Tuur123/GIP/Website/Website_GIP/Website_GIP/luchtvervuiling_3.jpg

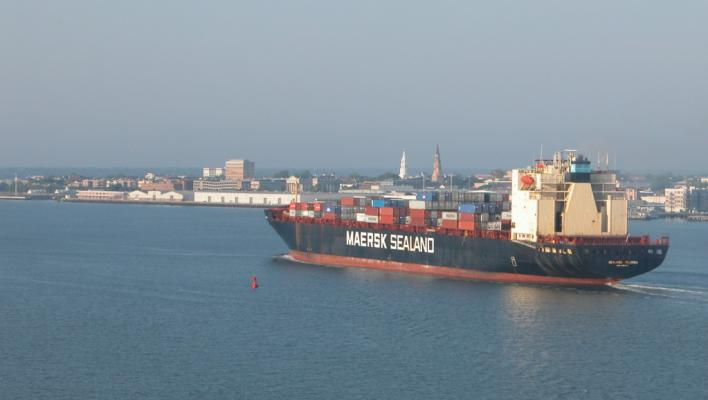
Website/Website_GIP/Website_GIP/luchtvervuiling_3.jpg
