Tuur123/GIP/Website/Website_GIP/Website_GIP/luchtvervuiling_1.jpg

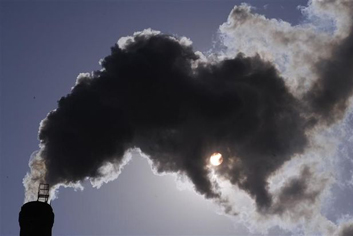
Website/Website_GIP/Website_GIP/luchtvervuiling_1.jpg
