Tuur123/GIP/README.md

# GIP
Luchtkwaliteit

Geïntegreede proef van Arthur d'Hooge en Ruben Socquet
