Tuur123/GIP/GIP-PPT-2_RS_AdH.pptx

## Luchtkwaliteit

Door: R. Socquet & A. d’Hooge

## Samenvatting

- Beoogde eindresultaat
- Belangrijke schema’s
- Werkpunten proces 1
- Stand van zaken

## Beoogde eindresultaat

- Meter dat locatie, tijd, temperatuur, vochtigheid, CO² en lichtsterkte meet.
- Data naar website via WAN module of SD-kaart.
- Metingen gebonden aan de ingelogde gebruiker.
- Grafieken locatie en gebruiker gebonden maken.
- Duidelijk overzicht van de luchtkwaliteit evolutie weergeven.

## Belangrijke schema’s


## Belangrijke schema’s


## Werkpunten proces 1

- Mogelijkheid om data lokaal te bewaren. SD-kaart
- Map op de website. Mapbox
- Intervallen tussen metingen zijn snelheidsafhankelijk.

## Stand van zaken

- Energie voorziening van het meettoestel herbekijken.
- Alle data in clusters op de web pagina.
- Website gebruiksvriendelijker maken.
- Website werkend krijgen (markers)
- Veiligheidsbeleid ontwikkelen
  - User uploaden bestanden
  - Mogelijkheid om data van andere users op te vragen
  - Directe user input naar database (SQL Injection)

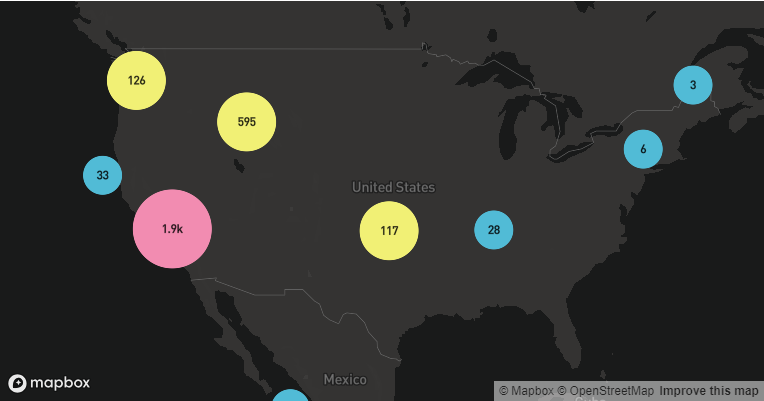
[picture p99: figure]
