Tuur123/GIP/Bundel/To do list 1.0.docx

To do list

- bundel bijwerken – opdrachten proces 3
  - handleiding
- Website datalistener nakijken, volgorde?
- website mooier maken (verdere uitleg toevoegen)(Ruben)
- Website beveiliging?
- website kunnen hosten
