Tuur123/GIP/Bundel/GIP - Opdrachtenbundel - ontwerp.docx

# Opdrachtenbundel

# Geïntegreerde proef 6TICT

# 2018 – 2019

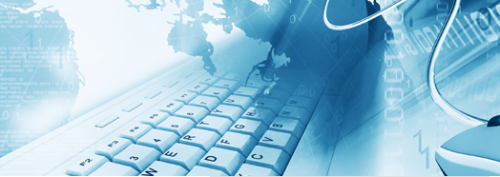
[picture p100: figure]

# Opdrachtenbundel

Opmerking:

De uitwerkingen van de verschillende opdrachten worden steeds toegevoegd aan de GIP-bundel. Bij de opgegeven momenten wordt steeds een volledige bundel afgedrukt en afgegeven aan de GIP-mentor (algemene vakken) en wordt een tweede afdruk gemaakt voor nazicht door de technische leerkrachten.

Bij de evaluatie van de opdrachten kan de attitudeschaal mee in rekening gebracht worden.

# Projectverdeling

Project: | Leerlingen: | Begeleiding:
| | D. Pauwels
| | D. Pauwels
| | D. Pauwels
| | G. Wagemans
| | G. Wagemans
| | G. Wagemans
| | T. Willemsen

# Evaluaties

De evaluatiemomenten met de externe juryleden zullen doorgaan op de volgende momenten:

Procesevaluatie 1 - vrijdag 18 januari

Procesevaluatie 2 - vrijdag 29 maart

Productevaluatie - woensdag 05 juni

In de loop van het ganse schooljaar zal permanente evaluatie, opvolging en begeleiding doorlopend plaatsvinden.

# Projectmatig werken

Opdracht: | Deadlines:
1) Definitiestudie - Werk aan de hand van de projectomschrijving van de GIP een definitiestudie uit die een gedetailleerde beschrijving van het eindresultaat geeft. - Probleemstelling - Specificaties - Functionaliteit - Hardware - Software - Gebruikers - Veiligheid - Etc. | 1e periode = … /01/19 = Procesevaluatie 1
2) Detailontwerp - Werk aan de hand van de definitiestudie het detailontwerp uit. Beschrijf de technische opbouw en werking van de opstelling van het eindproduct. - Schematisch - Hardware - Software en bibliotheken - Dataverwerking - Processturing - Communicatie - Garanties en veiligheid - Etc. | 1e periode = … /01/19 = Procesevaluatie 1
3) Materialenlijst - Stel aan de hand van het detailontwerp een gedetailleerde materialenlijst samen (hardware + software). | 1e periode = … /01/19 = Procesevaluatie 1
4) Dossier Proces 1 - Lever een GIP-dossier in volgens de aangeboden structuur waarin alle onderdelen van de verschillende vakken die deel uitmaken van de GIP uitgewerkt worden volgens de gemaakte afspraken. | 1e periode = … /01/19 = Procesevaluatie 1
5) Presentatie Proces 1 - Maak een presentatie waarin minstens volgende elementen aanwezig zijn: - Titel-dia - Korte omschrijving van je opdracht (zie GIP-info) - Samenvatting van de definitiestudie - Detailontwerp (enkel schema’s, toelichting geef je mondeling) - Stand van zaken (Hoe verloopt het project? Wat staat er nog op de planning? Heb je al testopstellingen gemaakt?) Dien de presentatie minstens één maal in op papier. | 1e periode = … /01/19 = Procesevaluatie 1
6) Voorstelling Proces 1 - Je presentatie zal je mondeling toelichten voor de vakjury. Tijdens deze bespreking wordt er eveneens gekeken naar inzichten en methodische aanpak (SAM-schaal) van het project, alsook kennis over je bundel. Praktische realisaties worden in het labo gedemonstreerd en maken deel uit van de presentatie. | 1e periode = … /01/19 = Procesevaluatie 1

7) Dossier Proces 2 - Lever een GIP-dossier in volgens de aangeboden structuur waarin alle onderdelen van de verschillende vakken die deel uitmaken van de GIP uitgewerkt worden volgens de gemaakte afspraken. | 2e periode = …/03/19 = Procesevaluatie 2
8) Presentatie Proces 2 - Maak een presentatie waarin minstens de volgende elementen aanwezig zijn: - Titel-dia - Omschrijving het beoogde eindresultaat - Toelichting van het detailontwerp - Belangrijke schema’s - Bespreking van de werkpunten die gegeven werden tijdens proces 1 - Huidige stand van zaken + aanpak richting de productevaluatie - … Dien de presentatie minstens één maal in op papier. | 2e periode = …/03/19 = Procesevaluatie 2
9) Voorstelling Proces 2 - Je presentatie zal je mondeling toelichten voor de vakjury. Tijdens deze bespreking wordt er eveneens gekeken naar inzichten en methodische aanpak (SAM-schaal) van het project, alsook kennis over je bundel. Praktische realisaties worden in het labo gedemonstreerd en maken deel uit van de presentatie. | 2e periode = …/03/19 = Procesevaluatie 2

10) Tutorial - Stel een tutorial op voor de ganse opstelling van het GIP-project. Mensen die het systeem zullen onderhouden moeten op documentatie terug kunnen vallen bij de uitvoering van nieuwe installaties, herstellings- en aanpassingswerken. | 3e periode = Bij inleveren dossier = …/05/19 = Productevaluatie
11) Technische conclusie - Formuleer je bevindingen (problemen, oplossingen, moeilijkheden, etc.) in de loop van het project. - Reflecteer over het eindresultaat. | 3e periode = Bij inleveren dossier = …/05/19 = Productevaluatie
12) Zelfreflectie - Evalueer jezelf. Reflecteer over je eigen prestaties, vorderingen, vaardigheden, problemen en competenties die je ondervond tijdens de uitvoering van je opdrachten. | 3e periode = Bij inleveren dossier = …/05/19 = Productevaluatie
13) Peer-evaluatie - Evalueer de samenwerking met anderen. Reflecteer over hun prestaties, vorderingen, vaardigheden, problemen en competenties tijdens samenwerkingen. | 3e periode = Bij inleveren dossier = …/05/19 = Productevaluatie

14) Logboek - Houd nauwkeurig bij welke prestaties je leverde tijdens de uitwerking van het project. Noteer steeds datums, tijdsduur, onderwerp, etc. | 3e periode = Bij inleveren dossier = …/05/19 = Productevaluatie
15) Dossier Product - Lever een GIP-dossier in volgens de aangeboden structuur waarin alle onderdelen van de verschillende vakken die deel uitmaken van de GIP uitgewerkt worden volgens de gemaakte afspraken. - Lever de ontwikkelde broncodes (software) in volgens de gemaakte afspraken. | 3e periode = Bij inleveren dossier = …/05/19 = Productevaluatie
16) Presentatie Product - Maak een presentatie waarin je je GIP-werk voorstelt. Dien de presentatie minstens één maal in op papier. | 3e periode = Bij inleveren dossier = …/05/19 = Productevaluatie
17) Voorstelling Product - Deze presentatie zal je mondeling toelichten voor de vakjury. Tijdens deze bespreking wordt er eveneens gekeken naar inzichten en methodische aanpak (SAM-schaal) van het project, alsook kennis over je bundel. Praktische realisaties worden in het labo gedemonstreerd en maken deel uit van de presentatie. | 3e periode = Bij voorstelling product = …/06/19 = Productevaluatie

# 1) Lokalisatie van wagons

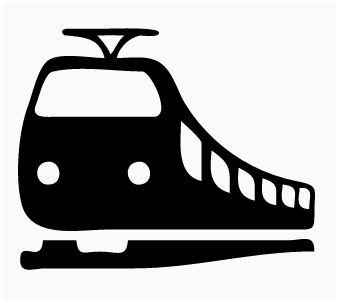
[picture p101: figure]

Leerlingen: Arno & Robbe Breens

## Projectomschrijving

Op een rangeerterrein voor het onderhouden van treinwaggons geraken regelmatig treinstellen tijdelijk verloren. Om het werk van het onderhoudsteam efficiënter te maken zal een systeem uitgebouwd worden dat er voor zorgt dat onderhoudsmedewerkers een specifiek treinstel sneller kunnen localiserern.

Kenmerken:
Gegevens tussen sensoren, actoren, server, camera en bewakingstoepassing worden over een LAN verstuurd.

Kernwoorden:

## Elektronica

Opdracht: | Deadlines:
15) Sensoren en actoren - Werk uit hoe de verschillende sensoren en/of actoren binnen je project aangesloten en gebruikt kunnen worden. Geef dit ook schematisch weer. - Aansluitschema - Elektronisch schema - Ontwikkel de software voor de microcontroller die de aangesloten sensoren en actoren kan uitlezen en aansturen. - Bewegingssensoren - Rooksensor - RFID - Akoestisch alarm - Seriële monitor (voor weergave van testresultaten) - LCD-display (voor weergave van testresultaten) - … | 1e periode = …/01/19 = Procesevaluatie 1

16) Voeding - Bepaal welke spanningen, stromen en vermogens er dienen aanwezig te zijn. Staaf dit met de nodige berekeningen. Ontwerp vervolgens een systeem voor de voorziening van voeding die aan alle eisen voor de opstelling voldoet. Beargumenteer duidelijk je gemaakte keuzes. - Ontwerp de PCB voor de aansluitingen van de voeding(en) die we nodig hebben om alle gevraagde vermogens te kunnen realiseren. | 2e periode = …/03/19 = Procesevaluatie 2
17) PCB design - Ontwerp en ontwikkel de schakeling(en) die gebruikt zal/zullen worden voor het uitmeten van de sensoren en aansturen van signalisatie en/of actuatoren. Gebruik hiervoor professionele ontwikkelsoftware op het gebied van PCB design. | 2e periode = …/03/19 = Procesevaluatie 2
18) PCB ontwikkeling - Ontwerp en ontwikkel een PCB die alle elektronica binnen het project samenbrengt en de nodige aansluitpunten voorziet. Zorg ervoor dat de nodige aansluitingen volgens de regels van goed vakmanschap zijn. Voorzie degelijke kabels (en cable management) om de noodzakelijke verbindingen te realiseren. - Integreer de gepaste voedingsvoorzieningen in de opstelling die de aanwezige schakelingen en componenten van energie voorzien. | 3e periode = Bij inleveren dossier = …/05/19 = Productevaluatie

## ICT

Opdracht: | Deadline:
19) Opbouw LAN-netwerk - Bouw het LAN op dat zal gebruikt worden tijdens het uitwerken van je GIP-project. - Werk een volwaardig netwerkdiagram uit | 1e periode = …/01/19 = Procesevaluatie 1
20) Webdesign - Maak een grafisch ontwerp van je webapplicatie. - Integreer in je project een gebruiksvriendelijke webinterface waarop alle nodige informatie voor je applicatie getoond kan worden, en waarlangs de gebruiker(s) interactie kan/kunnen hebben met de andere onderdelen van de toepassing. - Voorzie binnen je webinterface een plaats waar je eigenschappen van de toepassing kan instellen. | 1e periode = …/01/19 = Procesevaluatie 1
21) Database - De webinterface zal instaan voor het verwerken en bewaren van informatie die stroomt tussen de verschillende nodes van de applicatie. - Integreer in de webinterface van je project de mogelijkheid om gegevens te bewaren in een database. Belangrijke informatie die door de microcontroller of eindgebruikers wordt verzonden zal bewaard moeten worden in de database. - Wanneer een gebruiker van de applicatie gegevens wil bekijken of instellingen wil wijzigen, kan hij deze opvragen uit de database. | 1e periode = …/01/19 = Procesevaluatie 1

22) Netwerkcommunicatie server-microcontroller - Integreer in je project de mogelijkheid om via het LAN communicatie te voeren tussen de webapplicatie en de microcontroller. De webapplicatie kan data ontvangen van de aanwezige microcontroller(s) alsook informatie verzenden naar de microcontroller(s). | 2e periode = …/03/19 = Procesevaluatie 2
23) Netwerk-camera - Integreer de mogelijkheid om via de webinterface videobeelden van een netwerk- of webcamera weer te geven. Sluit een netwerk-camera aan op het LAN. Maak vervolgens een link vanuit de applicatie naar de camera om de videostream te tonen. | 2e periode = …/03/19 = Procesevaluatie 2
24) Toegankelijkheid via LAN - Maak je webapplicatie toegankelijk voor andere toestellen op het LAN. Zorg er voor dat je applicatie bekeken kan worden door meerdere andere (mobiele) toestellen zoals laptops, pc’s, tablets, smartphones, etc. | 3e periode = Bij inleveren dossier = …/05/19 = Productevaluatie
25) Broncode - Optimaliseren van de broncode: Lever alle geschreven software van het project (ook digitaal) in. Optimaliseer de code volgens de aangeleerde technieken. - Commentaar - Stijl - Efficiëntie - Header-informatie - OOP - Foutafhandeling - Etc. | 3e periode = Bij inleveren dossier = …/05/19 = Productevaluatie

## Elektriciteit

Opdracht: | Deadline:
26) Netstelsels - Onderzoek welk netstelsel er gebruikt wordt in je applicatie bij de voorziening van energie. - Maak een gevarenanalyse voor deze situatie. - Verantwoord de gebruikte beveiliging. | 1e periode = …/03/19 = Procesevaluatie 2
27) Vitale 8 - Om veilig te kunnen werken met de installatie is het van cruciaal belang dat je de vitale 8 uit de elektriciteit kent. Bespreek deze regels. | 2e periode = …/03/19 = Procesevaluatie 2
28) Risicoanalyse - Maak een risicoanalyse van de opstelling van je applicatie. | 2e periode = …/03/19 = Procesevaluatie 2
29) Elektrische componenten Onderzoek de types en kenmerken van de gebruikte elektrische toestellen in de praktische opstelling van je applicatie. | 3e periode = Bij inleveren dossier = …/05/19 = Productevaluatie
30) Elektrische schema’s Teken de elektrische schema’s van de omgeving waarbinnen je applicatie zich bevindt met het tekenpakket van SEE-electrical. | 3e periode = Bij inleveren dossier = …/05/19 = Productevaluatie

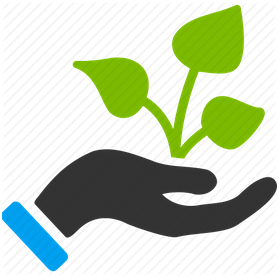
[picture p102: figure]

# 2) Greenhouse

Leerlingen: Robbe Elsermans & Melvin Goorden

## Projectomschrijving

Omwille van economische, ecologische, logistieke en kwalitatieve redenen wordt er in de ontwikkeling van landbouwtechnologieën vollop geëxperimenteerd met het kweken van gewassen in afgesloten omgevingen (indoor). Hiervoor zal een project uitgewerkt worden dat het mogelijk maakt om de eigenschappen van bodem en lucht waarin de gewassen groeien in kaart te brengen en op automatische wijze te beïnvloeden. Dit zal uiteindelijk leiden tot een optimalisatie van de kweekomstandigheden van de gewassen.

Kenmerken:
Er worden metingen uitgevoerd om de eigenschappen van de lucht uit de omgeving op te volgen: - Licht - Temperatuur - Vochtigheid - CO2
Er worden metingen uitgevoerd om de eigenschappen van de bodem uit de omgeving op te volgen: - vochtigheid
Er wordt een irrigatiesysteem uitgewerkt dat instaat voor de bevochtiging van de bodem. Onderzoek hierbij of er gebruik gemakt kan worden van regenwater, leidingwater of een combinatie van beiden.
Een meet- en regelsysteem zorgt voor een egale bevochtiging van de bodem.
Een meet- en regelsysteem zorgt voor een beïnvloeding van de eigenschappen van de lucht.
Er worden metingen uitgevoerd op het verbruik van water en elektriciteit.
De verschillende metingen moeten in kaart gebracht kunnen worden (grafieken/diagram) via een grafische webinterface.
De verschillende instellingen van het systeem moeten via een grafische webinterface instelbaar gemaakt worden.
Een camera maakt beelden van de omgeving waarin de gewassen groeien.
Gegevens tussen sensoren, actoren, webapplicatie en camera worden over een LAN verstuurd.

Kernwoorden:

# 3) Bulletin board

Leerlingen: Liam Smet

## Projectomschrijving

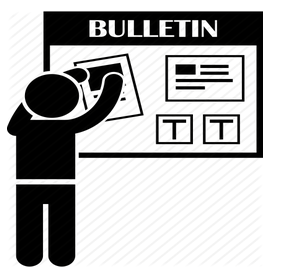
[picture p103: figure]

Om de interne communicatie van een bedrijf te verbeteren wordt een systeem uitgewerkt dat het mogelijk maakt om via een groot scherm mededelingen en algemene informatie te tonen aan personeelsleden. Dergelijk scherm zal op een centrale plaats binnen het bedrijf worden opgehangen.

Voor de beheerder van het systeem moet een interface voorzien worden die het mogelijk maakt om op eenvoudige wijze de boodschappen en inhoud van wat er op het bord verschijnt te kunnen aanpassen.

Kenmerken:
Er worden metingen uitgevoerd om de eigenschappen van de lucht uit de omgeving op te volgen: - Licht - Temperatuur - Vochtigheid
Er wordt een alarmsignaal voorzien dat de aandacht van medewerkers trekt wanneer een zeer belangrijke mededeling op scherm verschijnt.
Een webinterface wordt voorzien om meldingen te tonen en de informatie die via het systeem wordt getoond te beheren.
Een login-systeem voor de administrator van het systeem moet voorzien worden.
De videobeelden van een netwerkcamera tonen in de webinterface de weersomstandigheden buiten het bedrijf.
De verschillende metingen moeten in kaart gebracht kunnen worden (grafieken/diagram) via een grafische webinterface.
Gegevens tussen sensoren, actoren, webapplicatie en camera worden over een LAN verstuurd.

Kernwoorden:

# 4) Luchtkwaliteit

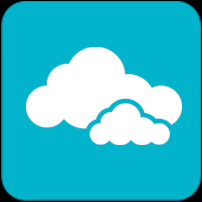
[picture p104: figure]

Leerlingen: Arthur d’ Hooge & Ruben Soquet

## Projectomschrijving

Om de luchtkwaliteit van een bepaalde regio in kaart te brengen zal een systeem uitgewerkt worden dat voor een bepaalde locatie exact kan bepalen welke de eigenschappen van de luchtkwaliteit zijn.

De meetresultaten worden vervolgens samengevoegd en uitgebreid in kaart gebracht.

Kenmerken:
Er worden metingen uitgevoerd om de eigenschappen van de lucht uit de omgeving op te volgen: - Licht - Temperatuur - Vochtigheid - CO2
Voor de verschillende metingen die worden uitgevoerd dient steeds een exacte locatie bepaald te worden aan de hand van GPS-coördinaten.
Het traject dat tijdens het afnemen van de meetproef werd afgelegd wordt in kaart gebracht.
De verschillende metingen moeten in kaart gebracht kunnen worden (grafieken/diagram/landkaart) via een grafische webinterface.
De verschillende instellingen van het systeem moeten via de grafische webinterface instelbaar gemaakt worden.
Een camera maakt beelden van de omgeving tijdens het uitvoeren van de metingen.
Gegevens tussen sensoren, actoren, webapplicatie en camera worden over een netwerk verstuurd.

Kernwoorden:

# 5) Human machine interface voor PLC

Leerlingen: William Bruijns

## Projectomschrijving

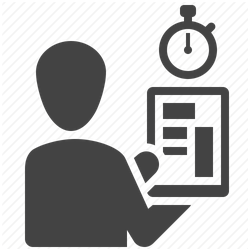
[picture p105: figure]

Voor de bediening van een industriële installatie met PLC’s moet een grafische interface (HMI - human machine interface) ontwikkeld worden. De communicatie tussen de HMI en de gebruikte PLC moet verlopen over het bedrijfsnetwerk. Op deze wijze zal de machine vanop een afstand aangestuurd kunnen worden door een operator.

Kenmerken:
Onderzoek de mogelijkheden die het softwarepakket Movicon te bieden heeft voor de uitwerking van een HMI.
Onderzoek de mogelijkheden die de bibliotheken van .NET te bieden hebben voor het uitwerken van een HMI.
Controllino en HMI
Ontwikkel voor beide aanpakken een HMI.
De ontwikkelde HMI’s moeten in staat zijn om start- en stopsignalen naar de PLC te sturen, alsook de waarden van metingen door de PLC te tonen in de grafische interface.
Videobeelden van een netwerkcamera tonen beelden van de omgeving van de machine-installatie.
Gegevens over sensoren, actoren en camera worden over een LAN verstuurd naar de HMI.
Een meet- en regelsysteem moet geïntegreerd worden in de installatie die door de HMI bediend zal worden.

Kernwoorden:

# 6) Pompinstallatie

Leerling(en): Luyks Arjen

## Projectomschrijving

Voor een watertoevoersysteem moet een systeem uitgewerkt worden waarmee de toeveoer van water geautomatiseerd kan worden. Om de omstandigheden te onderozken zal moeten bepaald kunnen worden welke hoeveelheden water er door het systeem vloeien.

Kenmerken:

Kernwoorden:

Geïntegreerde proef 6TICT Opdrachtenbundel 2018-2019
