Tuur123/GIP/Bundel/netwerkdiagram.png

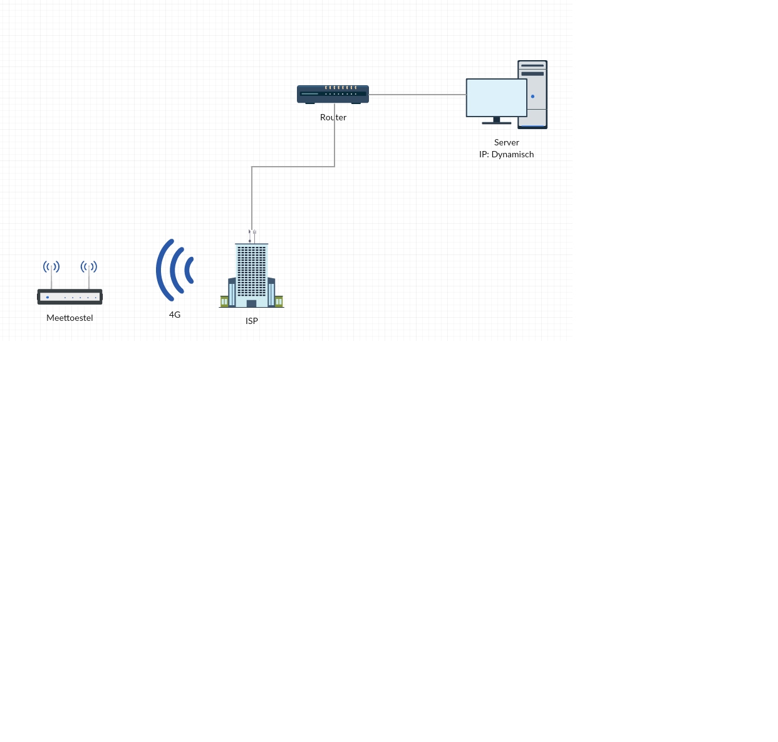
Bundel/netwerkdiagram.png
