Tuur123/GIP/Filmpjes/IMG_20190420_151055.jpg

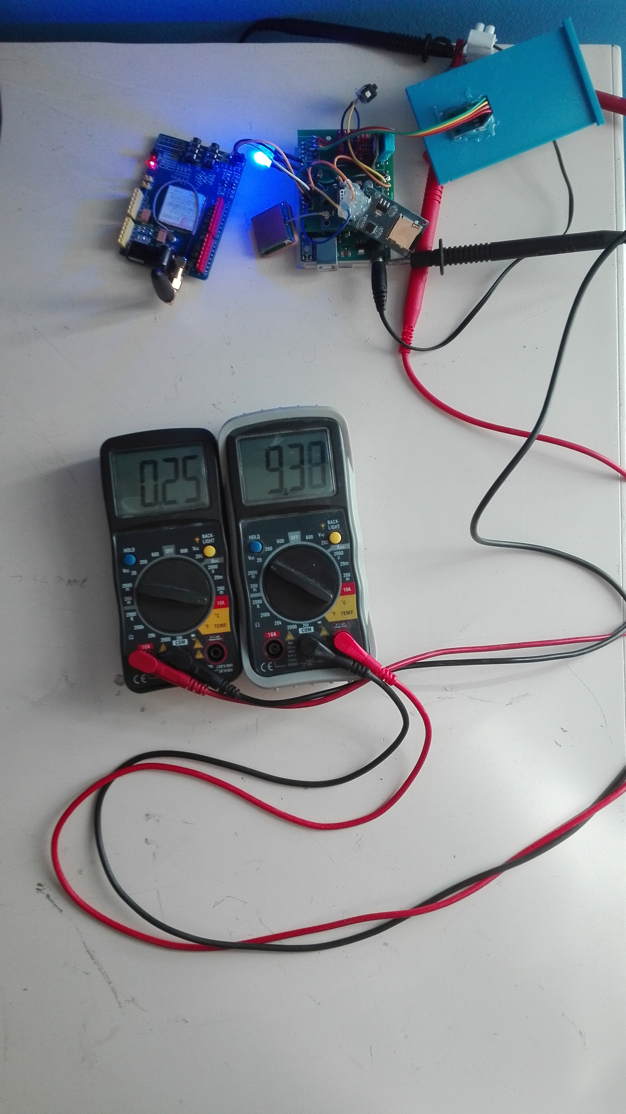
Filmpjes/IMG_20190420_151055.jpg
