Tuur123/GIP/Filmpjes/IMG_20190420_151147.jpg

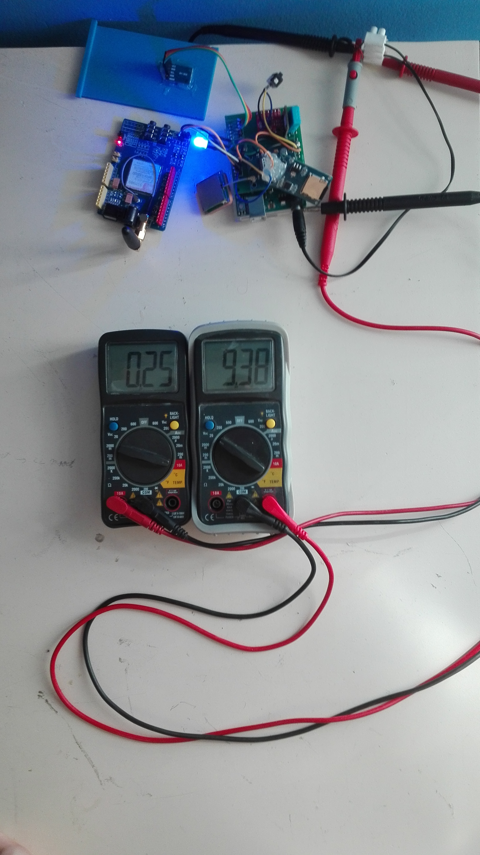
Filmpjes/IMG_20190420_151147.jpg
