Tuur123/GIP/Website/Website_GIP/Website_GIP/luchtvervuiling_2.jpg

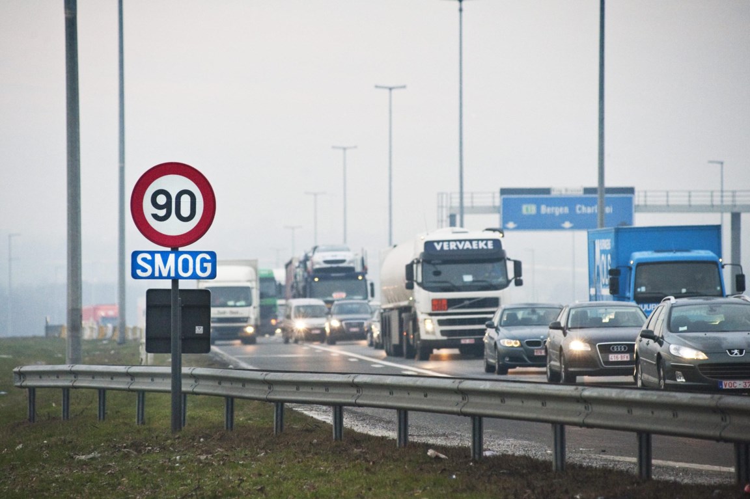
Website/Website_GIP/Website_GIP/luchtvervuiling_2.jpg
