Tuur123/GIP/Website/Website_GIP/Website_GIP/sideImage.png

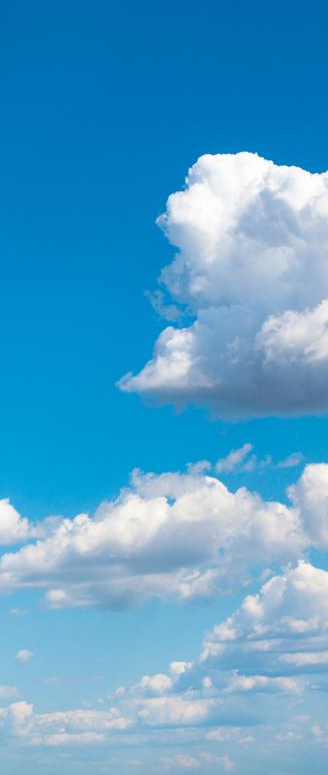
Website/Website_GIP/Website_GIP/sideImage.png
