Tuur123/GIP/Bundel/bestellijst.xlsx

MATERIALENLIJST LUCHTKWALITEIT
HARDWARE |  |  |  | SOFTWARE
naam: | Type: | link: | kostprijs: | naam: | type:
sensoren: |  |  |  | Visual Studio | IDE
licht | BH1750FVI | Link (https://www.ebay.com/itm/New-BH1750FVI-Digital-Light-intensity-Sensor-Module-For-Arduino-3V-5V-power/252335244805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) | $ 0,99 | Arduino IDE | IDE
CO2 | CCS811 | link | $ 24,14 | OneWire | Library
temperatuur & humidity | / | link (https://www.gearbest.com/development-boards/pp_76242.html?wid=1433363&currency=EUR&vip=16019847) | $2.13 | Wire | Library
Stroom | ACS712 | link (https://nl.aliexpress.com/item/Free-Shipping-Hot-Sale-ACS712-30A-Range-Hall-Current-Sensor-Module-ACS712-Module-For-Arduino-30A/32515954572.html) | €1.60 | CCS811 | Library
Spanning | / | link (https://nl.aliexpress.com/item/Smart-Electronics-DC0-25V-Standard-Voltage-Sensor-Module-Test-Electronic-Bricks-for-arduino-Robot/32823612964.html) | €0.24 | DHT | Library
Controllers:
Arduino | Uno | link (https://www.raspberrypi.org/products/raspberry-pi-3-model-b-plus/) | €39.95
GSM Shield | SIM900 | link (https://nl.aliexpress.com/item/SIM900-GPRS-GSM-Shield-Development-Board-Quad-Band-Module-For-Arduino-Compatible/32649551828.html) | $12.78
Voeding:
Batterij | 6x AA | link (https://www.allekabels.be/aa-batterij/4570/1284037/aa-batterij.html) | € 29,70
Batterij houder |  | link (https://www.tinytronics.nl/shop/nl/batterij-en-accu/batterijhouders/6x-aa-batterij-houder-met-losse-draden) | €3,00
