Tuur123/GIP/schema's/Case/onderkant.stl

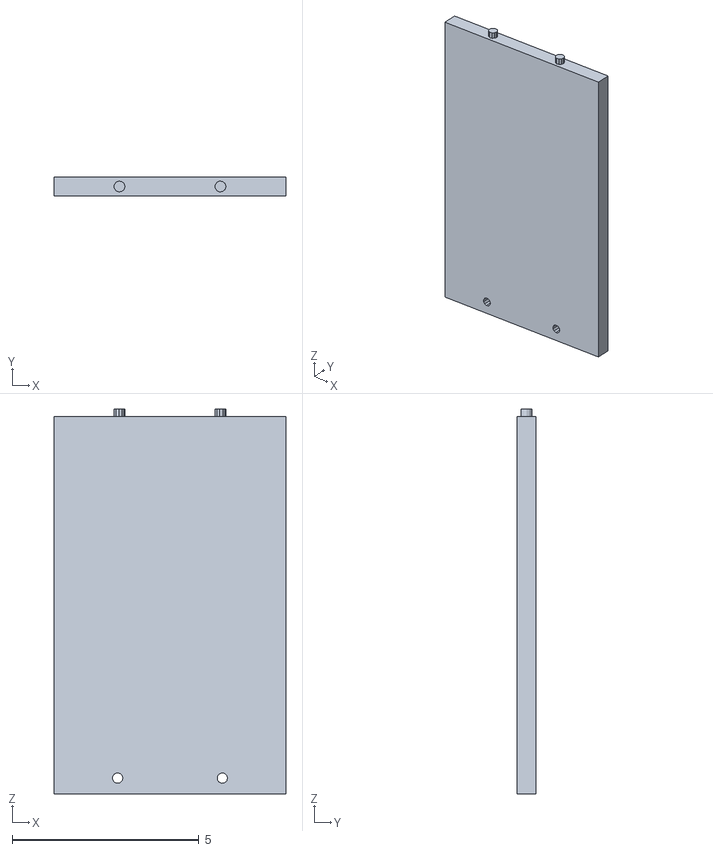
[picture p111: CAD file, 2019-02-27]
schema's/Case/onderkant.stl
6.20 x 0.5 x 10.3
