Tuur123/GIP/schema's/Case/deksel.stl

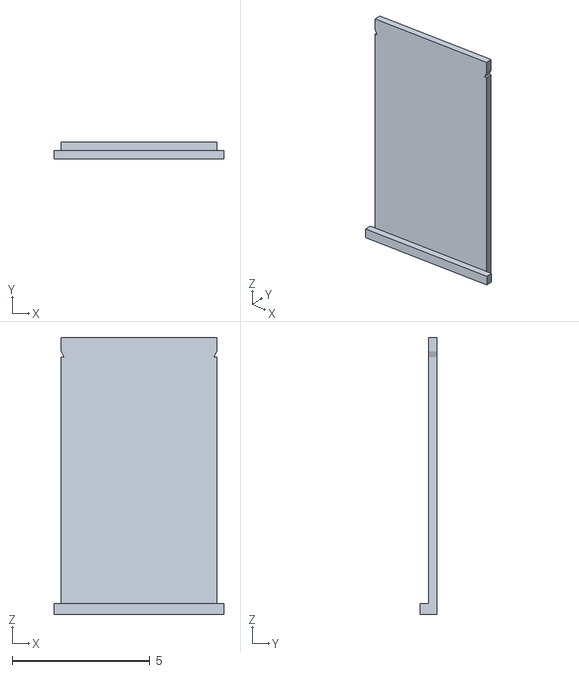
[picture p112: CAD file, 2019-02-27]
schema's/Case/deksel.stl
6.15 x 0.6 x 10.0
