Tuur123/GIP/schema's/Case/case.stl

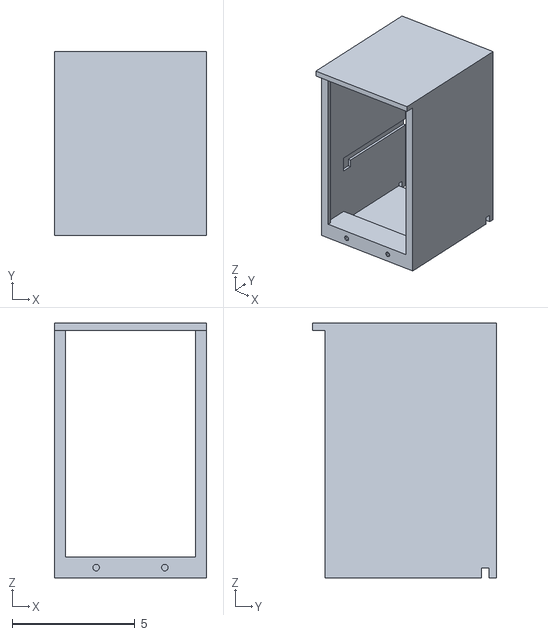
[picture p113: CAD file, 2019-02-27]
schema's/Case/case.stl
6.20 x 7.50 x 10.4
