Tuur123/GIP/PPT eindevaluatie.pptx

## Luchtkwaliteit

Door: Ruben Socquet en Arthur d’Hooge

## SAMENVATTING

- Het nut van de metingen
- Realisatie
- Het eindresultaat
- Niet bereikte doelstellingen
- Bijgeleerd

Luchtkwaliteit

## HET NUT VAN DE METINGEN

- Temperatuur & vochtigheid → evolutie opvolgen
- CO2 → temperatuur stijging
- Lichtsterkte → eventuele uitbreiding

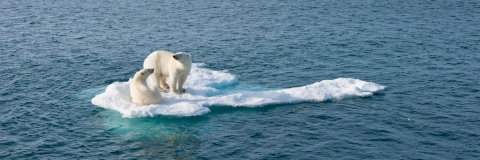
[picture p114: figure]
Afbeeldingsresultaat voor klimaatverandering
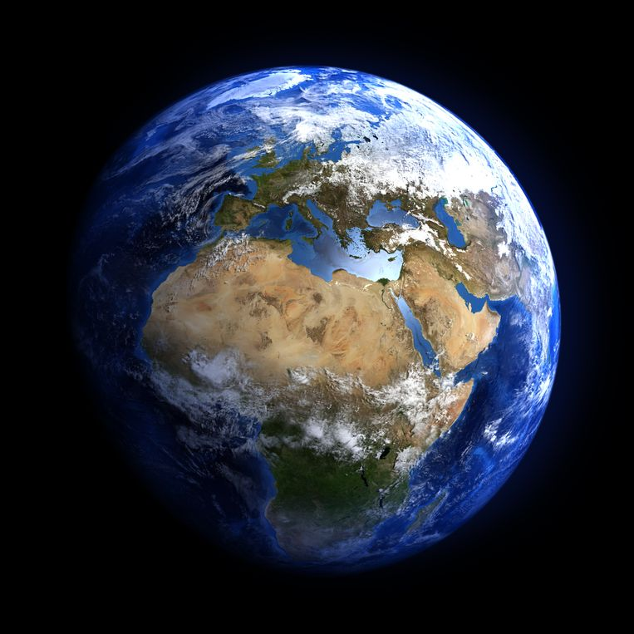
[picture p115: figure]
Afbeeldingsresultaat voor klimaatverandering

## REALISATIE


## HET EINDRESULTAAT

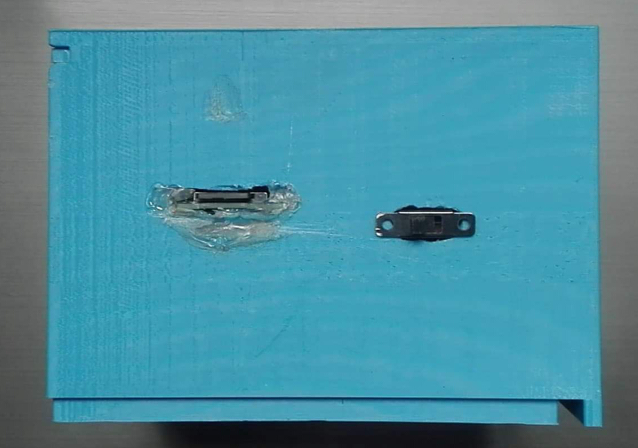
[picture p116: figure]
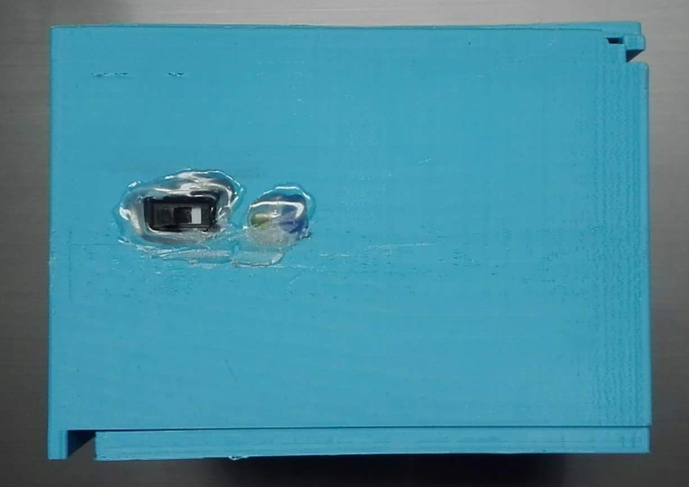
[picture p117: figure]
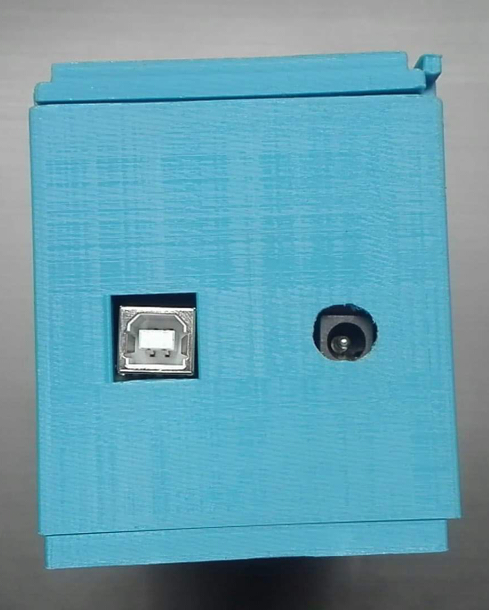
[picture p118: figure]

## Slide 6

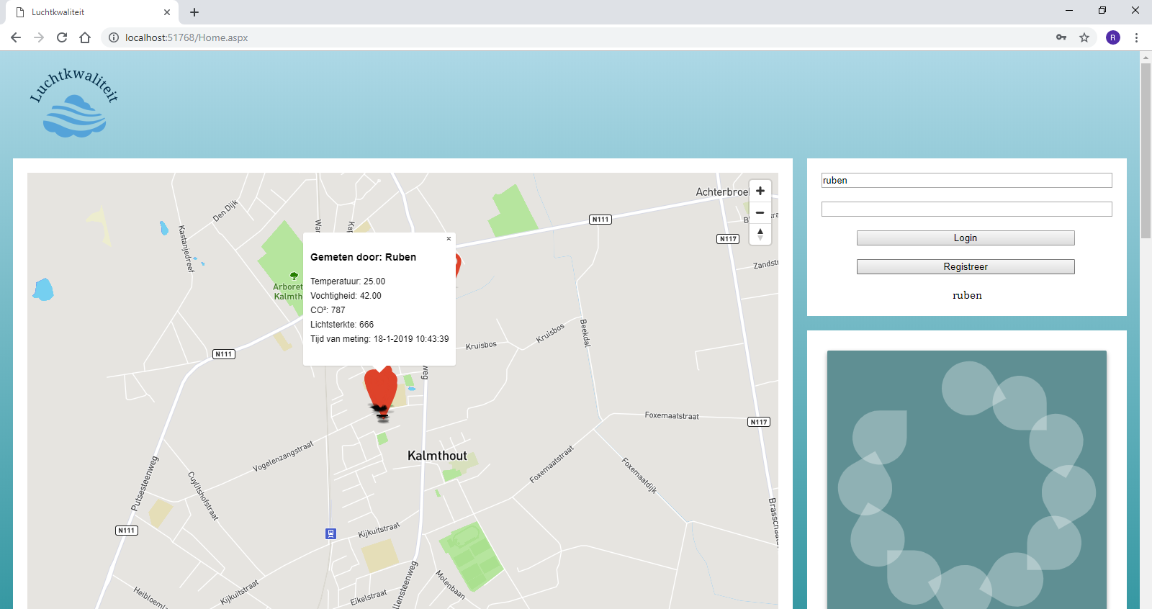
[picture p119: figure]
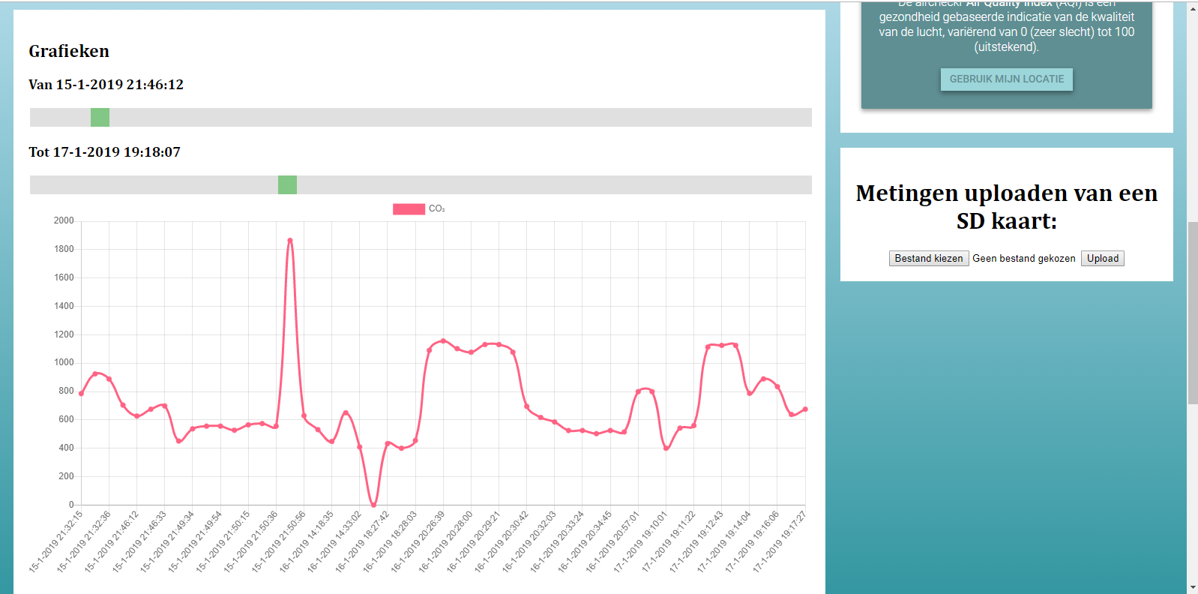
[picture p120: figure]

## NIET BEREIKTE DOELSTELLINGEN

- Hosten van de website

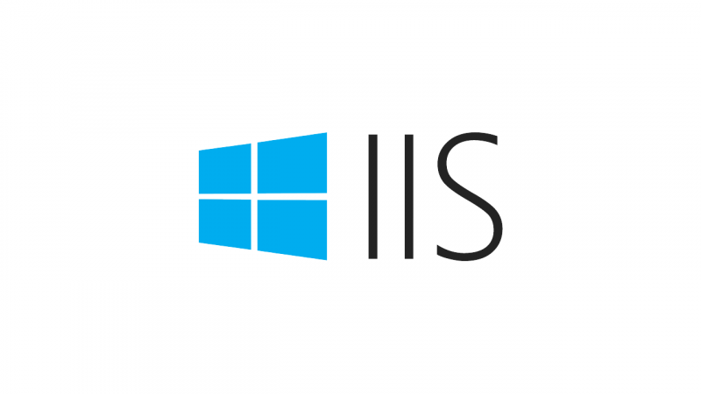
[picture p121: figure]
Afbeeldingsresultaat voor IIS

## BIJGELEERD

- Projectwerk
- Nieuwe programmeertalen
- Web development

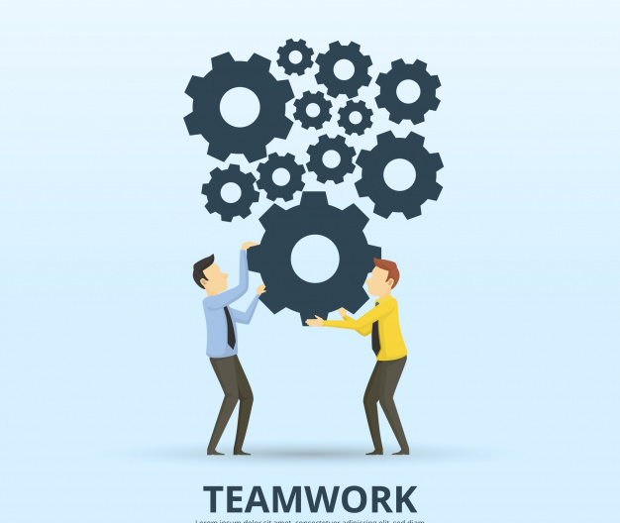
[picture p122: figure]
Afbeeldingsresultaat voor teamwork
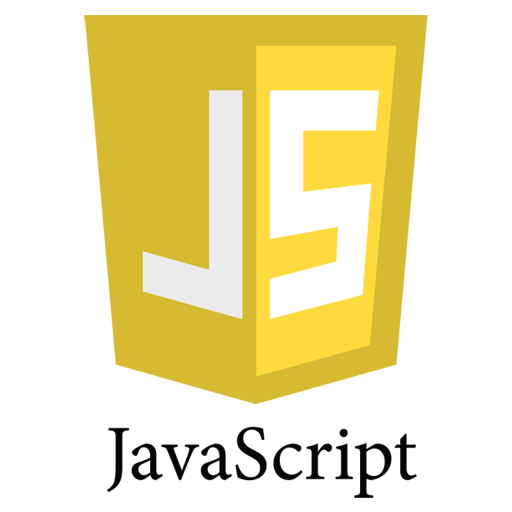
[picture p123: figure]
Afbeeldingsresultaat voor javascript
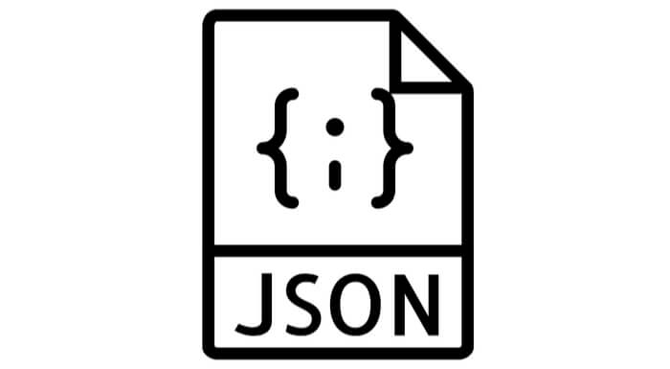
[picture p124: figure]
Afbeeldingsresultaat voor json
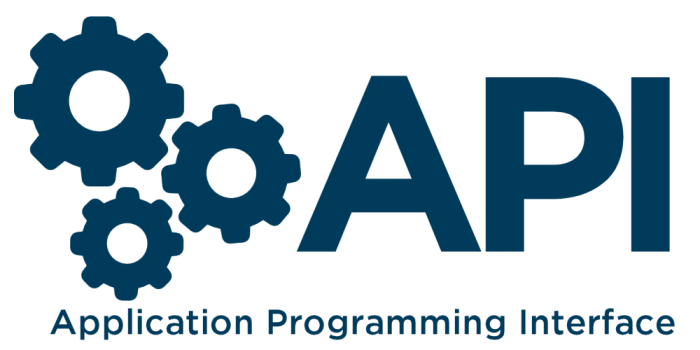
[picture p125: figure]
Afbeeldingsresultaat voor api
