Tuur123/GIP/schema's/GIP-client.pdf

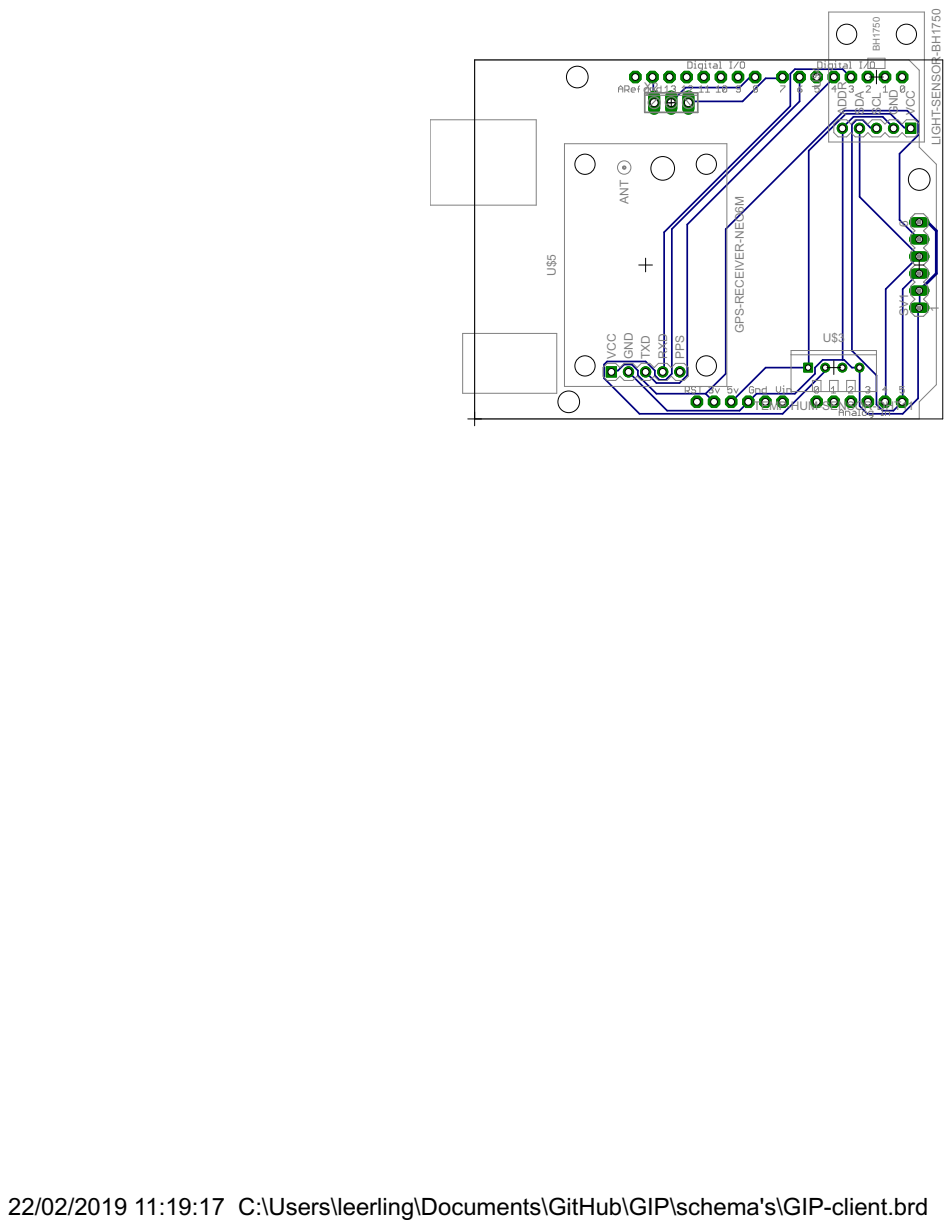
[picture p126: page 1]

22/02/2019 11:19:17 C:\Users\leerling\Documents\GitHub\GIP\schema's\GIP-client.brd
