Tuur123/GIP/schema's/GIP-client.brd

## EAGLE design schema's/GIP-client.brd (2019-03-28)

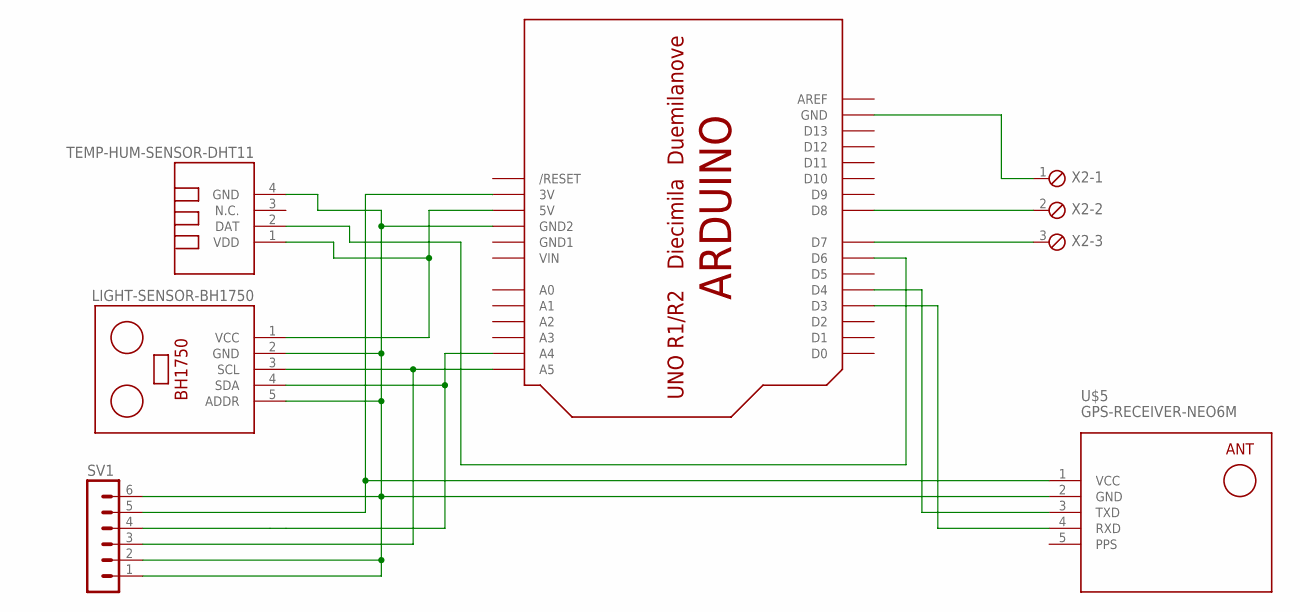
[picture p127: schematic GIP-client.sch]

Parts:
SV1: MA06-1
U$2: ARDUINO-BPLACE
U$3: TEMP-HUM-SENSOR-DHT11
U$4: LIGHT-SENSOR-BH1750
U$5: GPS-RECEIVER-NEO6M
X2: MPT3; 3POL254

Connections:
GND1: U$2.GND1
unnamed: U$2.GND, X2.1
unnamed: U$2.D8, X2.2
unnamed: U$2.D7, X2.3
unnamed: SV1.1, SV1.2, SV1.6, U$2.GND2, U$3.4 (GND), U$4.2 (GND), U$4.5 (ADDR), U$5.2 (GND)
unnamed: U$2.D6, U$3.2 (DAT)
unnamed: SV1.4, U$2.A4, U$4.4 (SDA)
unnamed: SV1.3, U$2.A5, U$4.3 (SCL)
unnamed: U$2.5V, U$3.1 (VDD), U$4.1 (VCC)
unnamed: SV1.5, U$2.3V, U$5.1 (VCC)
unnamed: U$2.D4, U$5.3 (TXD)
unnamed: U$2.D3, U$5.4 (RXD)
PPS: U$5.5 (PPS)
VIN: U$2.VIN

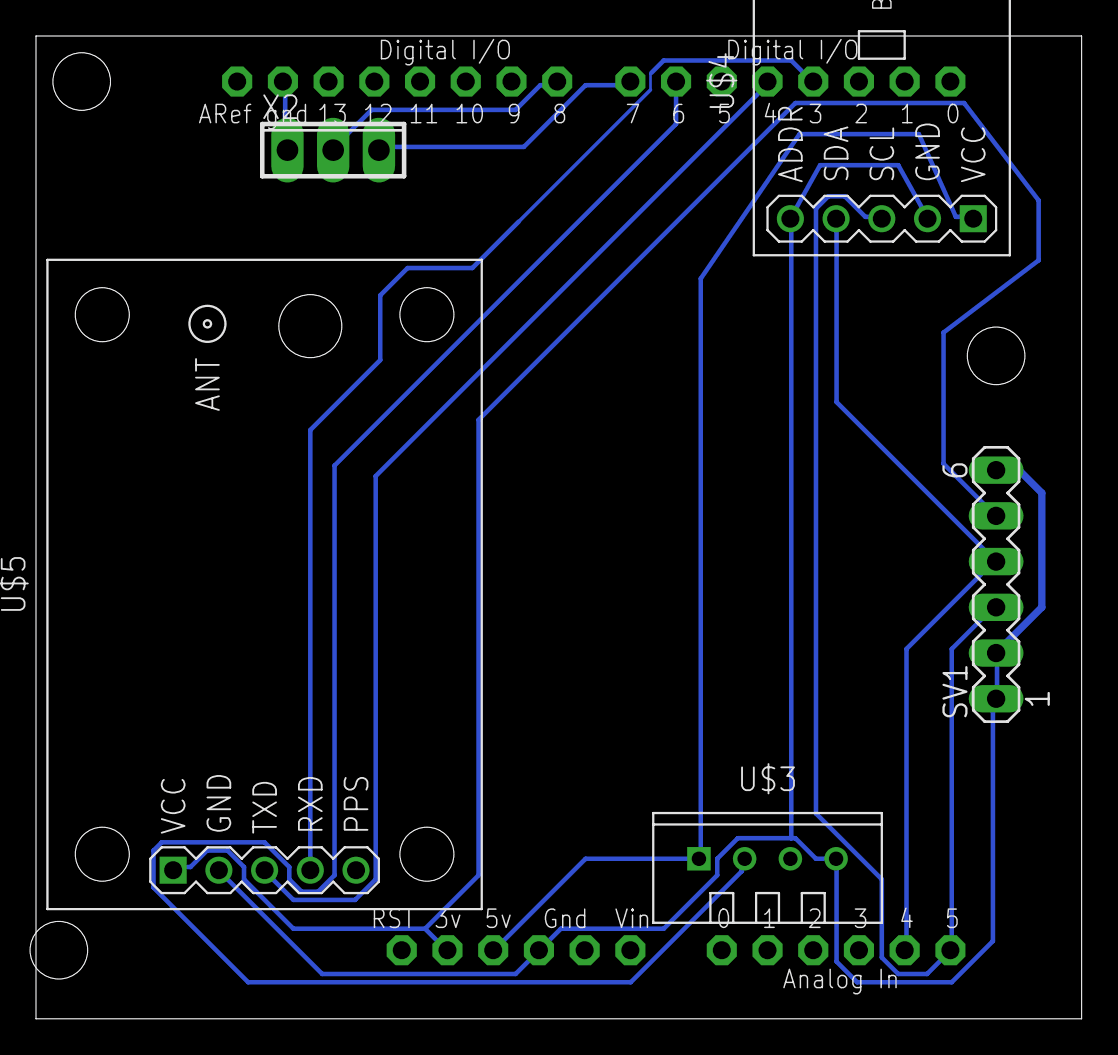
[picture p128: board GIP-client.brd from above]

Board: 2 copper layers, 58.1 x 54.6 mm, 6 parts (0 on the bottom side), 11 nets.
