Tuur123/GIP/schema's/Shield_behuizing.brd

## EAGLE design schema's/Shield_behuizing.brd (2019-02-22)

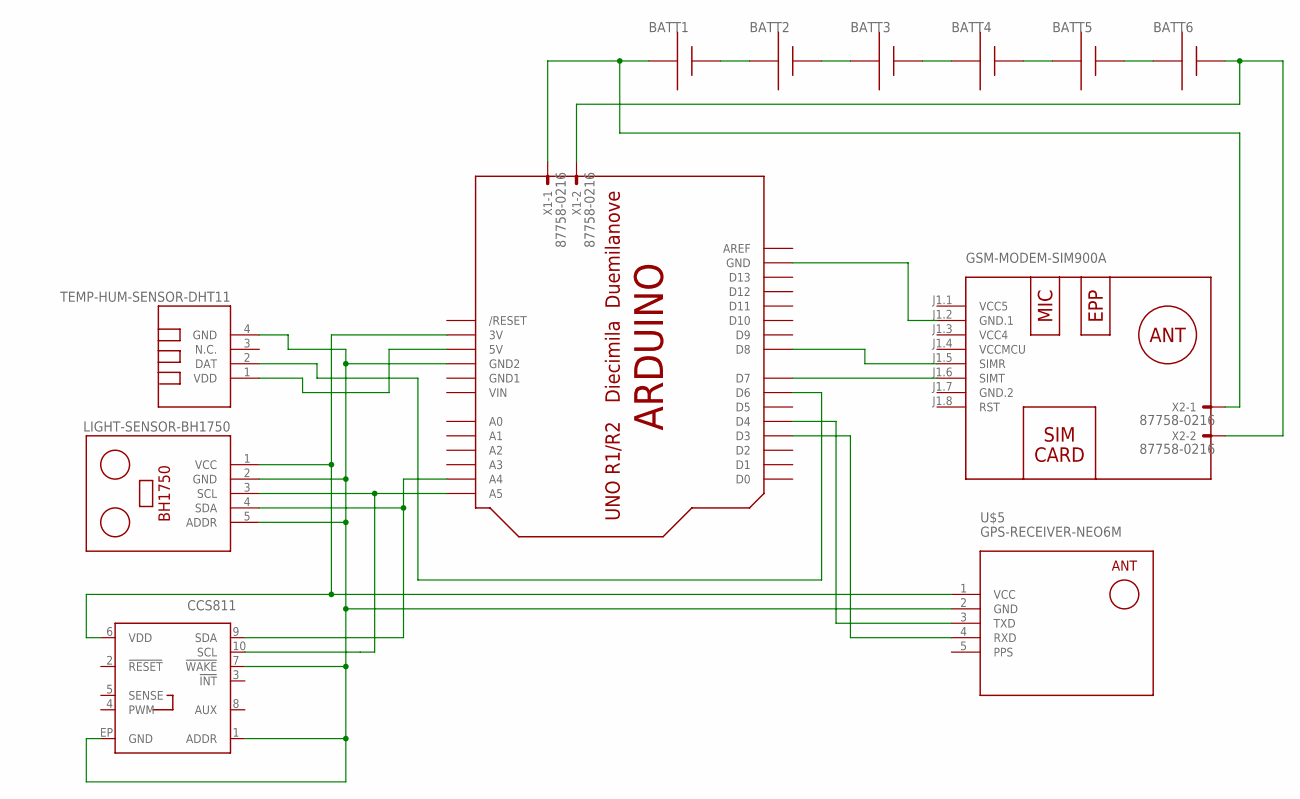
[picture p129: schematic Shield_behuizing.sch]

Parts:
BATT1, BATT2, BATT3, BATT4, BATT5, BATT6: AAA; 12BH412
U1: CCS811; LGA10
U$1: GSM-MODEM-SIM900A
U$2: ARDUINO-BPLACE
U$3: TEMP-HUM-SENSOR-DHT11
U$4: LIGHT-SENSOR-BH1750
U$5: GPS-RECEIVER-NEO6M
X1, X2: 87758-0216

Connections:
GND1: U$2.GND1
GND.2: U$1.J1.7 (GND.2)
unnamed: U$1.J1.2 (GND.1), U$2.GND
unnamed: U$1.J1.5 (SIMR), U$2.D8
unnamed: U$1.J1.6 (SIMT), U$2.D7
unnamed: BATT1.+, BATT2.-
unnamed: U1.1 (ADDR), U1.7 (!WAKE!), U1.EP (GND), U$2.GND2, U$3.4 (GND), U$4.2 (GND), U$4.5 (ADDR), U$5.2 (GND)
unnamed: U$2.D6, U$3.2 (DAT)
unnamed: U1.9 (SDA), U$2.A4, U$4.4 (SDA)
unnamed: U1.10 (SCL), U$2.A5, U$4.3 (SCL)
unnamed: U$2.5V, U$3.1 (VDD)
unnamed: BATT2.+, BATT3.-
unnamed: BATT3.+, BATT4.-
unnamed: BATT4.+, BATT5.-
unnamed: BATT5.+, BATT6.-
unnamed: U1.6 (VDD), U$2.3V, U$4.1 (VCC), U$5.1 (VCC)
unnamed: U$2.D4, U$5.3 (TXD)
unnamed: BATT1.-, X1.1, X2.1
unnamed: BATT6.+, X1.2, X2.2
unnamed: U$2.D3, U$5.4 (RXD)
PPS: U$5.5 (PPS)
VCC4: U$1.J1.3 (VCC4)
VCC5: U$1.J1.1 (VCC5)
VCCMCU: U$1.J1.4 (VCCMCU)
VIN: U$2.VIN

Board: 2 copper layers, 14 parts (0 on the bottom side), 18 nets, no tracks yet.
