Tuur123/GIP/(commit log)

2018-10-23 Create Sensors
2018-10-26 C02 Sensor
2018-10-26 Create humidity en temp sensor
2018-11-05 netwerkdiagram + het eigenlijke werk
2018-11-19 Bijgewerkt en afgedrukt
    [bestellijst.xlsx]
2018-11-20 Software toegevoegd
    [bestellijst.xlsx]
2018-12-17 logboek
    ik heb het logboek ineens mee in de bundel gestoken
    makkelijker om in te vullen
2018-12-26 data listener toegevoegd
    de listener zal luisteren naar data van meettoestel op een specifieke poort en zal deze in de database zetten
2019-01-07 Bundel nu met versie nummers
    Als we nu tegelijk aan die bundel werke kunne we de elkaars werk ni per ongeluk weg doen da leek mij wel goe idee om me nummers te werke
2019-01-08 AA batterijen toegevoegd
    [bestellijst.xlsx]
2019-01-08 Add files via upload
    sensoren uitgebreider toegevoegd aan de bundel. CO² sensor WERKT NIET! Dus nog niet toegevoegd
2019-01-10 C02 sensor gefixtttt
    ge moest blijkbaar ook Wire.h toevoegen
2019-01-11 schema's en libraries
    [GIP-BH1750.sch, GIP-CCS811.sch, GIP-DHT11.sch, GIP-SIM900.sch, GIP-client.sch, GIP-gps.sch]
2019-01-11 brol verwijdert
    [Schema_pcb.brd, Schema_pcb.sch]
2019-01-12 Database.cs klasse uitgewerkt, website uitgewerkt
    website heeft nu een registreer pagina, user worden in database gezet, login methode is gemaakt. het enige voor de website wat nog moet gebeuren is data van sensors erop zetten en kaart inorde brengen
2019-01-12 sensormetingen + gps werken samen: andere code gebruikt voor gps
2019-01-14 Dit is de server app
2019-01-16 Kan jij de GIP-server.zip runnen op je pc aub
2019-01-17 Deze is zeker de werkende
2019-02-22 buttons gefixed
2019-02-22 pcb gemaakt
    [GIP-client.brd, GIP-client.sch, Shield_behuizing.brd, Shield_behuizing.sch]
2019-02-22 Pcb afgemaakt
    [GIP-client.brd]
2019-02-27 behuizing afgemaakt
    [case.stl, deksel.stl, onderkant.stl]
2019-03-13 OPLOSSING VOOR DE MARKESS
    in javascript maken we een for loop en voila probleem gefixt
2019-03-14 Verschillende problemen opgelost
    GeoJSON werkt; hiep hiep hoera
    Nu moeten we manier zoeken om van client side JavaScript de json files van de server te halen.
2019-03-15 ik irriteerde me aan die \n
    lijn 139 in Home.aspx
2019-03-16 SD-kaart uploader bij website toegevoegd WERKT! + volledige Arduino code
2019-03-19 code nagekeken
    er moeten veiligheden ingebouwd worden bij de file upload, anders is sql injection een gevaar en kan er bs in de db gezet worden. server kan ook compleet crashen
2019-03-19 api werkt blijkbaar niet in een gewoon asp project zoals de onze
2019-03-19 Ik heb tinne haar commentaar allemaal aann gepast en die bundel mooi gemaakt echt KKKKKAAANKER zooi
    IK WORD HEELEMAAL WAUW
2019-03-20 emc toe aan het voegen
2019-03-21 pcb erin gezet
2019-03-27 het werkt. Ik weet niet precies aan wat het lag
2019-03-28 gerber files voor pcb
    [GIP-client.brd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]
2019-03-28 pcb besteld
    [GIP-client.brd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]
2019-04-13 proberen charts te laten scrollen
2019-04-20 to do list aangevuld, ik zal de website mooier maken.
2019-04-23 vanallees
    - check bij de listener gemaakt zodat slechte data niet in database komt
    - arduino code nog wat cleaner gemaakt
2019-05-05 arduino code ziet er goed uit
2019-05-07 ip server in arduino code aangepast naar hostname
2019-05-08 nog wijzigingen gedaan in de bundel verbeter met mama
2019-05-09 Dit heb ik geüpload in de projectmap uploadzone
2019-05-29 kijk socket test om server te simuleren
2019-05-31 De code om te bepalen wanneer de gps geen connectie heeft werkt niet
2019-05-31 code database.cs toegevoegd maar het geheel moet nog getest worden
2019-06-01 Bij toevoegen data aan de db word de gemeente van meting bepaald en in db gezet
    db_listener klasse verwijdert, data word in listener.cs in db gezet. code voor api bevraging staat ook in listener.cs en in database.cs. TODO: bij client Javascript sorteren op gemeentes
2019-06-01 webmethod returned nu ook de gemeente in json string
